ArrowElectronicsESC/BluetoothXpressShield/Design Documents/PBOM.xlsx

Item# | Designator | Quantity | Production Description_SL | Production MFG_SL | Production P/N_SL
0 | PCB | 1 | 2.1X2.7,2 | Bittele | 49975B#0_20181128
1 | Y1 | 1 | Crystals 32.768KHz 7pF | Abracon Corporation | ABS07-32.768KHZ-7-T
2 | U3 | 1 | Consigned part: Imported | Consigned part: Analog Devices Inc. | Consigned part: ADG3308BRUZ or ADG3308BRUZ-REEL7
3 | U4 | 1 | IC REG LINEAR 3.3V 300MA TSOT5 | Analog Devices Inc | ADP122AUJZ-3.3-R7
4 | U7, U8, U9, U10 | 4 | Trans GP BJT NPN 45V 1A 2000mW Automotive 4-Pin(3+Tab) SOT-223 T/R | Diodes Incorporated | BCP5410TA
5 | U2 | 1 | Consigned part: BGX13S | Consigned part: Silicon Labs | Consigned part: BGX13S or BGX13S22GA-V21
6 | C1, C2, C3, C5, C6, C21 | 6 | Consigned part: Cap Ceramic 10V Pad SMD 0402 125°C T/R | Consigned part: Taiyo Yuden | Consigned part: C0402C104K8RAC or LMK105B7104MVHF
7 | C7, C8 | 2 | Consigned part: Cap Ceramic 10V Pad SMD 0402 125°C T/R | Consigned part: Taiyo Yuden | Consigned part: C0402C104K8RAC or LMK105B7104MVHF
8 | C11, C12, C13, C14, C17, C18, C19, C20 | 8 | Consigned part: Cap Ceramic 10V Pad SMD 0402 125°C T/R | Consigned part: Taiyo Yuden | Consigned part: C0402C104K8RAC or LMK105B7104MVHF
9 | C9, C10, C15, C16 | 4 | CAP CER 0.1UF 10V Y5V 0402 | KEMET Corporation | C0402C104Z8VAC7867
10 | R11 | 1 | Thick Film Resistors - SMD 1/16watt 91ohms 5% | Vishay Intertechnologies | CRCW040291R0JNED
11 | R25, R29, R39, R43 | 4 | RES SMD 1K OHM 1% 1/16W 0402 | Vishay Dale | CRCW04021K00JNEDC
12 | R7, R8, R9, R10 | 4 | Thick Film Resistors - SMD 1/16watt 1.5Kohms 1% Commercial Use | Vishay Intertechnologies | CRCW04021K50FKEDC
13 | R16, R18, R30, R32 | 4 | Thick Film Resistors - SMD 1/16watt 3.3Kohms 5% Commercial Use | Vishay Intertechnologies | CRCW04023K30JNEDC
14 | R2, R3,R44,R45 | 4 | Thick Film Resistors - SMD 1/16watt 7.5Kohms 5% | Vishay Intertechnologies | CRCW04027K50JNED
15 | R1, R4 | 2 | RES SMD 33 OHM 5% 1/16W 0402 | Vishay Dale | CRCW040233R0JNEDC
16 | R20, R21, R22, R23, R24, R26, R27, R28, R34, R35, R36, R37, R38, R40, R41, R42 | 16 | RES SMD 100K OHM 1% 1/16W 0402 | Vishay Dale | CRCW0402100KFKED
17 | R17, R19, R31, R33 | 4 | RES SMD 200K OHM 1% 1/16W 0402 | Vishay Dale | CRCW0402200KFKED
18 | R5, R6 | 2 | Thick Film Resistors - SMD 1/16watt 499Kohms 1% Commercial Use | Vishay Intertechnologies | CRCW0402499KFKEDC
19 | U5 | 1 | Operational Amplifiers - Op Amps Quad 1.8V 1MHz | Microchip Technology Inc | MCP6004T-I/ST
20 | H2 | 1 | TERM BLOCK 5.08MM HORZ 5POS PCB | On-Shore Technology Inc | OSTTC052162
21 | U6 | 1 | LED Lighting Drivers 4BIT I2C FM+ TP LED CON RST OE | NXP Semiconductors | PCA9633DP2,118
22 | S1, S2, S3, S4 | 4 | Tactile Switches TACT | C&K Components | PTS645SH50SMTR92LFS
23 | R12 | 1 | Thick Film Resistors - SMD 1/16W 49.9 Ohm 1% | YAGEO Corporation | RC0402FR-0749R9P
24 | R15 | 1 | RES SMD 56.2 OHM 1% 1/16W 0402 | YAGEO Corporation | RC0402FR-0756R2L
25 | R14 | 1 | Thick Film Resistors - SMD 63.4 OHM 1% | YAGEO Corporation | RC0402FR-0763R4L
26 | R13 | 1 | RES SMD 205 OHM 1% 1/16W 0402 | YAGEO Corporation | RC0402FR-07205RL
27 | U1 | 1 | Consigned part: Temp Sensor Digital Serial (I2C) 6-Pin DFN EP T/R | Consigned part: Silicon Labs | Consigned part: SI7050-A20-IMR
28 | AD1 | 1 | Consigned part: CONN RCPT .100" 6POS SNGL GOLD | Consigned part: Samtec Inc | Consigned part: SSQ-106-02-G-S or SSQ-106-03-F-S
29 | IOL1 | 1 | Consigned part: SSQ-108-03-G-S | Consigned part: Samtec Inc | Consigned part: SSQ-108-03-G-S
30 | POWER1 | 1 | Consigned part: SSQ-108-03-G-S | Consigned part: Samtec Inc | Consigned part: SSQ-108-03-G-S
31 | IOH1 | 1 | Consigned part: SSQ-110-03-F-S | Consigned part: Samtec Inc. | Consigned part: SSQ-110-03-F-S
32 | D4, D8 | 2 | Consigned part: Imported | Consigned part: Visual Communications Company - VCC | Consigned part: VAOL-S8GT4
33 | D5 | 1 | Standard LEDs - SMD Red 624nm | Visual Communications Company | VAOL-S8RP4
34 | D6 | 1 | Standard LEDs - SMD Blue 468nm | Visual Communications Company | VAOL-S8SB4
35 | D7 | 1 | LED WHITE DIFFUSED 0805 SMD | Visual Communications Company | VAOL-S8WR4
36 | U11 | 1 | Consigned part: Light to Digital Ambient Light Sensor Digital Output 3.3V 6-Pin T/R | Consigned part: Vishay Semiconductor Opto Division | Consigned part: VEML6030
37 | D1, D2 | 2 | Standard LEDs - SMD 0402 BLUE Non-Diff | Vishay Intertechnologies | VLMB1500-GS08
38 | D3 | 1 | Standard LEDs - SMD 0402 SUPER RED Non-Diff | Vishay Intertechnologies | VLMS1500-GS08
39 | U12 | 1 | MOSFET 2N-CH 20V 0.3A 6-DFN | Diodes Incorporated | DMN2005DLP4K-7
40 | J6 | 1 | Consigned part: | Consigned part: Samtec | Consigned part: SSQ-114-03-T-S
