ArrowElectronicsESC/BluetoothXpressShield/(threads)

Thread 2 (2019-03-04):

Missing schematics

stomascik, 2019-03-04:
Hello,

can you please release .pdf schematics of this board? In the Design Documents/BGX13_Shield_V1_0.zip are assembly files only.

Thank you.
Slavomir Tomascik

ebeppler03, 2019-04-23:
Slavomir - I have attached them here and they will be added to the next Github update.
[BGX_Shield_V1_0.pdf](https://github.com/ArrowElectronicsESC/BluetoothXpressShield/files/3108199/BGX_Shield_V1_0.pdf)

microwattbott, 2019-04-23:
Dear Sir,
     Thanks.  I needed that.  I cannot seem to get any
signal/voltage/current from the LED screw block.  The BLE works great
mostly.  I had a led and resistor in series connected to red and ground and
the default is totem mode on that output.   No Joy.  it did not light up
and my VOM could not detect any signal.  The onboard LEDs flash perfectly.
Are there a known problems with the  PCA9633 output drive on the
SLASH1000A?  I set the .ino Global variable OUTPUT_MODE to 1 and it made no
difference to detecting signal at the LED block.   I added the following
code to try and get the PCA9633 to send the signal to the external LED
driver.  Still no joy.
  if (!OUTPUT_MODE)  {    // could not get a single led to light
                          //on PWM output for lighting controller
    dimmer->onBoardMode();  // !! deduced solution :  independent
               // power supply required for "lighting controller"
              //  due to "open drain" congifuration  * change
                 // made from totem-pole config
  } else   {      // looked at this to see if program can get
                              // control of the invert verses
    dimmer->outputMode();   // non-invert parameter for PCA9633
                         // enable lighting controller output.
 }
Can you please point me in the right direction?

Thanks.

On Tue, Apr 23, 2019 at 10:08 AM ebeppler03 <notifications@github.com>
wrote:

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

ebeppler03, 2019-04-23:
Hi Microwattbott,

FYI the Screw block terminal is a 0-10V dimming controller designed for use with a system like this: https://www.arrow.com/en/products/ess030w-0500-56/energy-recovery-products-erp

The output is not driven, but is rather a current sinking output. This is a very common control system used in lighting systems. More info can be found here: https://en.wikipedia.org/wiki/0-10_V_lighting_control

Thanks!

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

microwattbott, 2019-04-23:
thank you, the wiki link for 0-10 V lighting control
<https://en.wikipedia.org/wiki/0-10_V_lighting_control> will be very useful.
I am wanting to test the output block without spending $40.00 for the extra
hardware.  I am going to check if my flourescent fixtures to see if I have
one that is dimmable with the 0-10 V control.   Thanks again for the wiki
link and the circuit *schematic *diagram.

On Tue, Apr 23, 2019 at 10:56 AM ebeppler03 <notifications@github.com>
wrote:

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

microwattbott, 2019-04-28:
A little web research led me to an easy to understand home brew lighting control circuit that should be usable with the SLASH1000A terminal block OR just an Arduino.  Here is the link : [https://maker.pro/arduino/projects/arduino-lamp-dimmer](https://maker.pro/arduino/projects/arduino-lamp-dimmer).
Of course, four of that circuit would be needed to use the full RGBW capabilities or the SLASH1000A.

Closed 2019-04-23.

Thread 3 (2019-04-23):

CHALLENGE OF FINDING THE INFO WHEN USING THE SLASH1000A

microwattbott, 2019-04-23:
Yes, I know it is the .pdf includes a link to the github.  BUT the .pdf has been un-linked from the arrow.com page for the board.
This is what I need:     Some where on this github page AND in the (all) zipped files MUST be included the device's name:  SLASH1000A.   Is there any bonafide reason for creating this firewall of secrecy?  The github search engine should direct me to these pages when I query it for SLASH1000A.  My PC should find the zip file on my harddrive when I look for SLASH100A.

ebeppler03, 2019-04-23:
Hi microwattbott - Sorry for the confusion - The github link has been re-added to the SLASH1000A page on Arrow.com. Unfortunately the 'SLASH1000A' Name was decided on fairly late in the process so the name isn't on all the materials - A readMe will be added to the next update to help mitigate this and provide installation instructions for the library.

Closed 2019-04-23.
