ArrowElectronicsESC/BluetoothXpressShield/Design Documents/BGX_Shield_V1_0.pdf

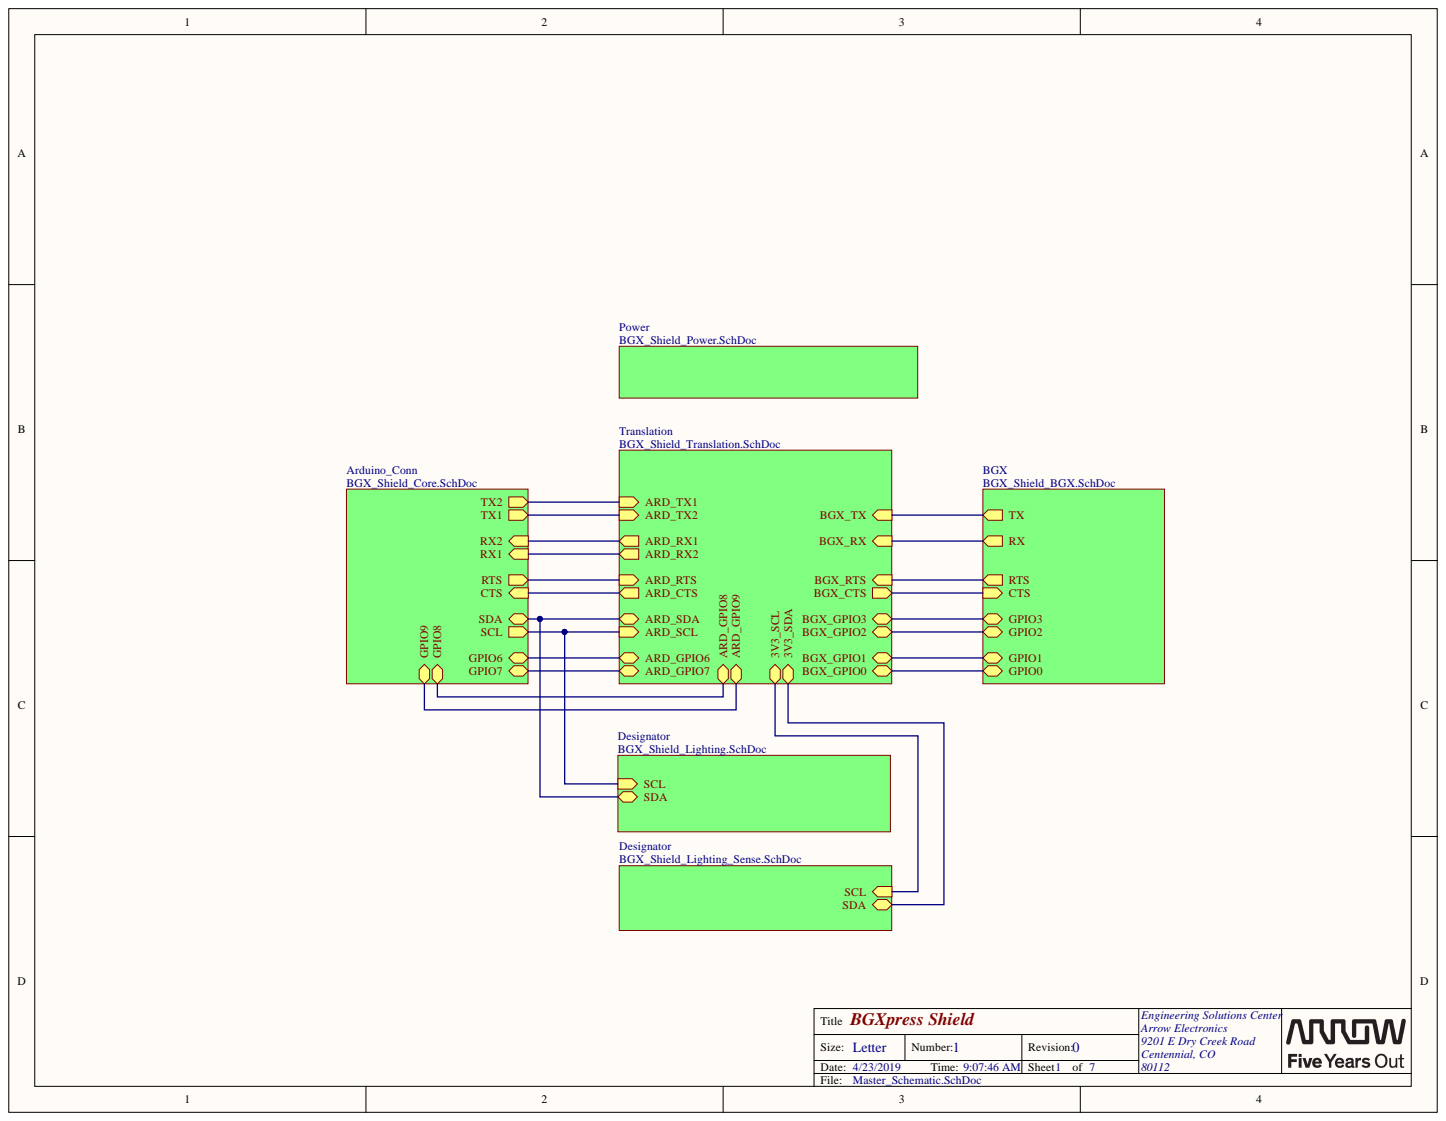
[picture p4: page 1]

Designator BGX_Shield_Lighting.SchDoc

SCL SDA

BGXpress Shield Title | Engineering Solutions Center Arrow Electronics 9201 E Dry Creek Road Centennial, CO

Size: Letter | Number: | Revision:
Date: 4/23/2019 Time: 9:07:46 AM | | Sheet of

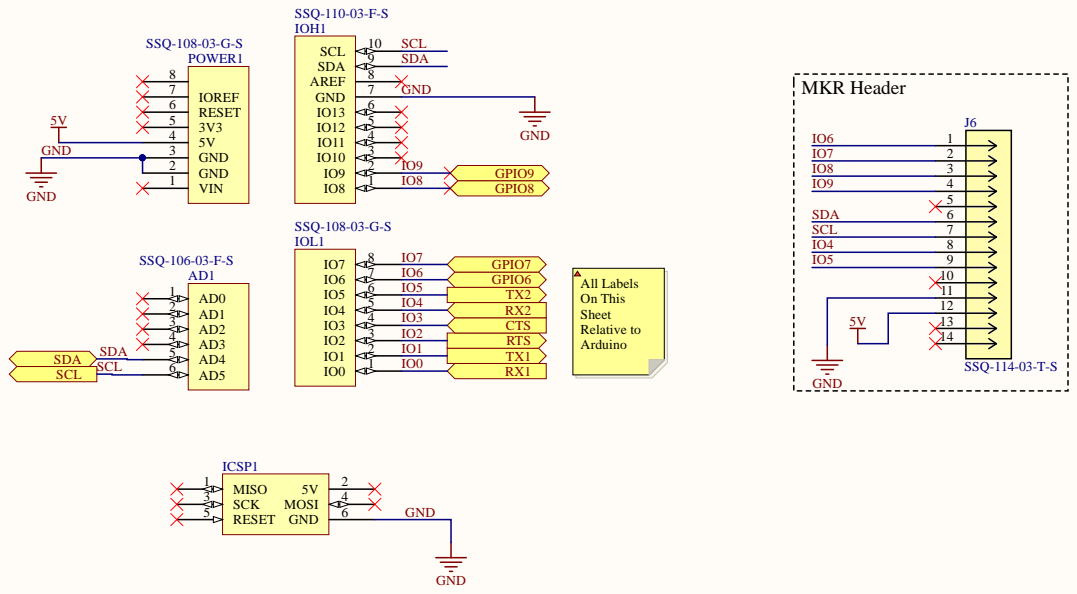
[picture p5: page 2]

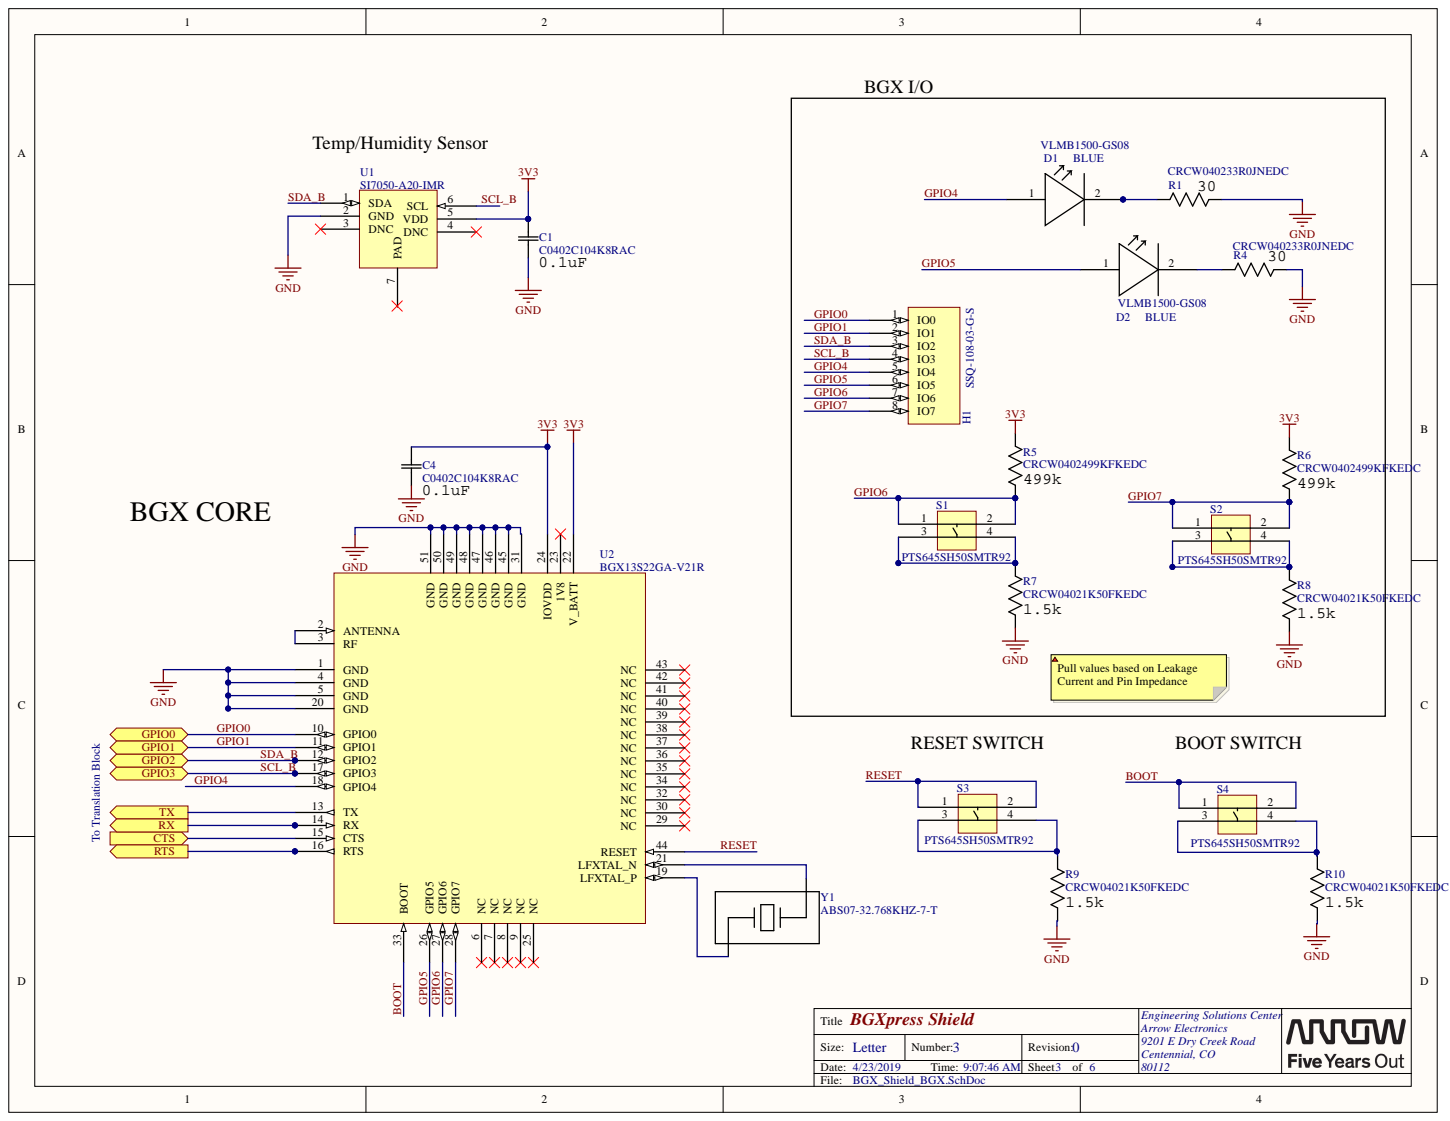
[picture p6: page 3]

GND 45 GND 46 GND 47 GND 48 GND 49 GND 50 GND 51

Pull values based on Leakage
Current and Pin Impedance

GND 4
GND 5
GND 20

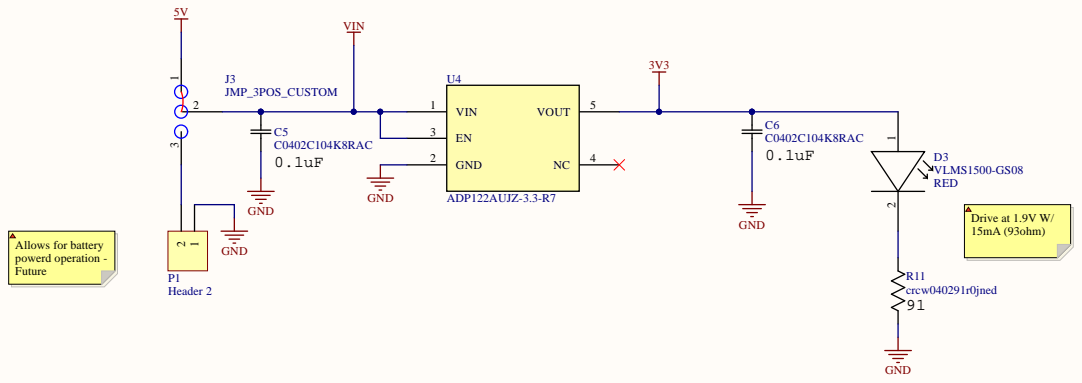
[picture p7: page 4]

Engineering Solutions Center Arrow Electronics 9201 E Dry C reek Road Centennial, C O

Number:

4/23/2019 Time: 9:07:46 A M | | Sheet of

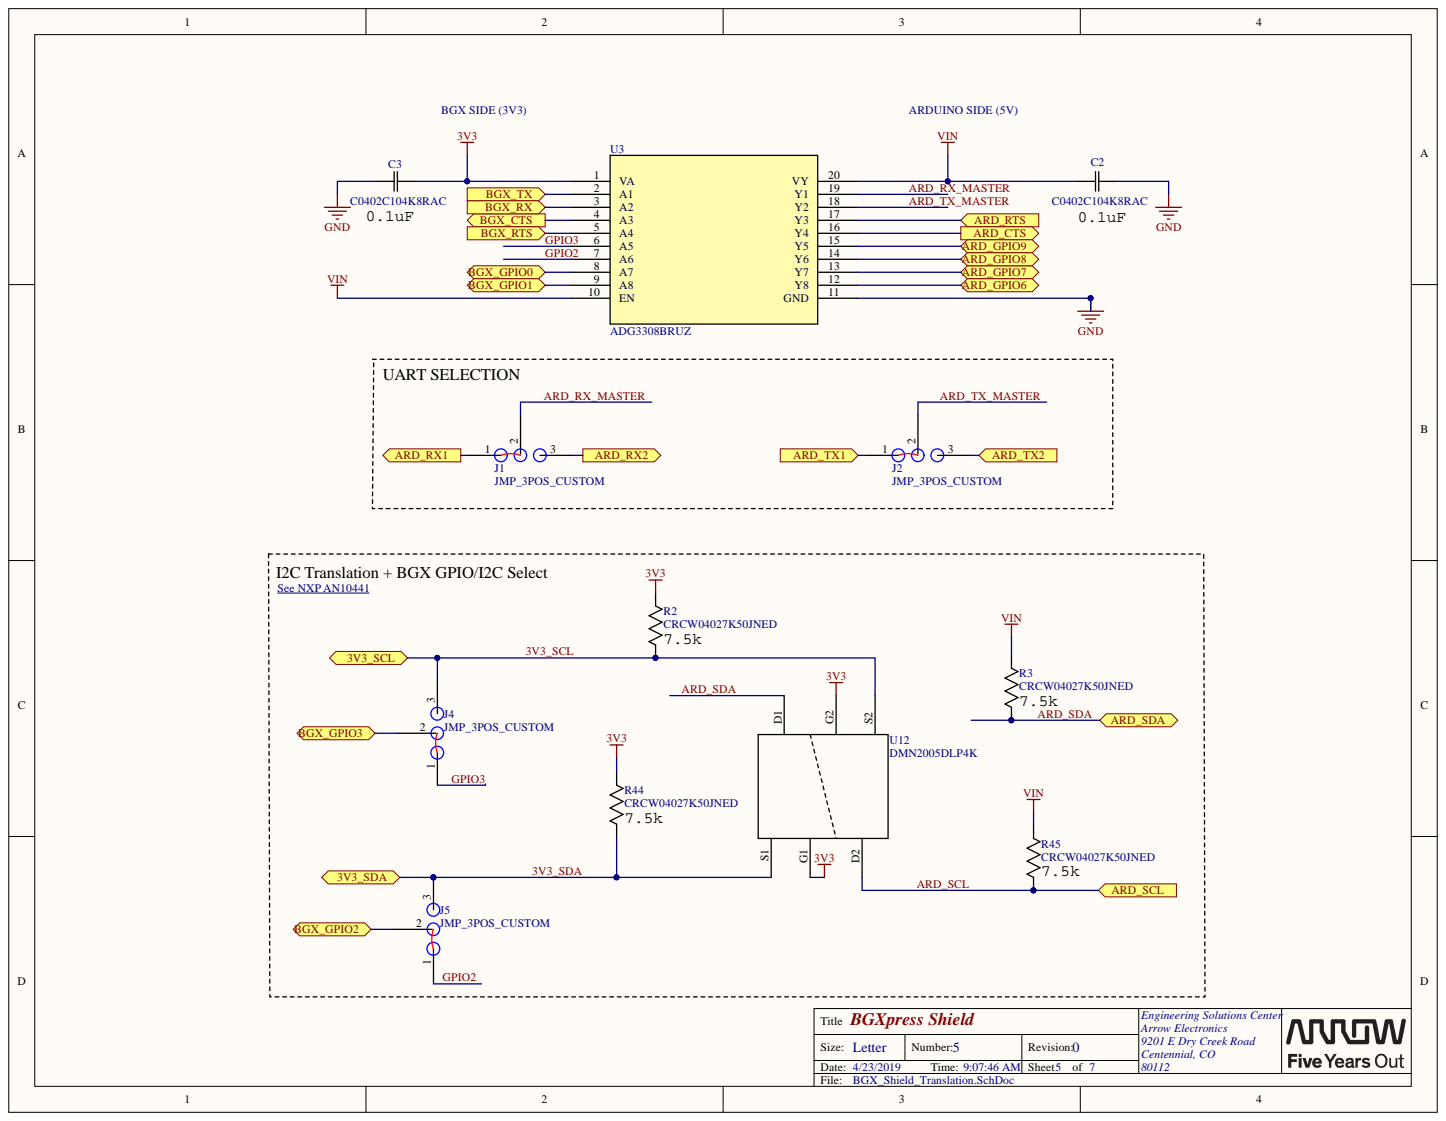
[picture p8: page 5]

I2C Translation + BGX GPIO/I2C Select See NXP AN10441 (https://cdn-shop.adafruit.com/datasheets/AN10441.pdf)

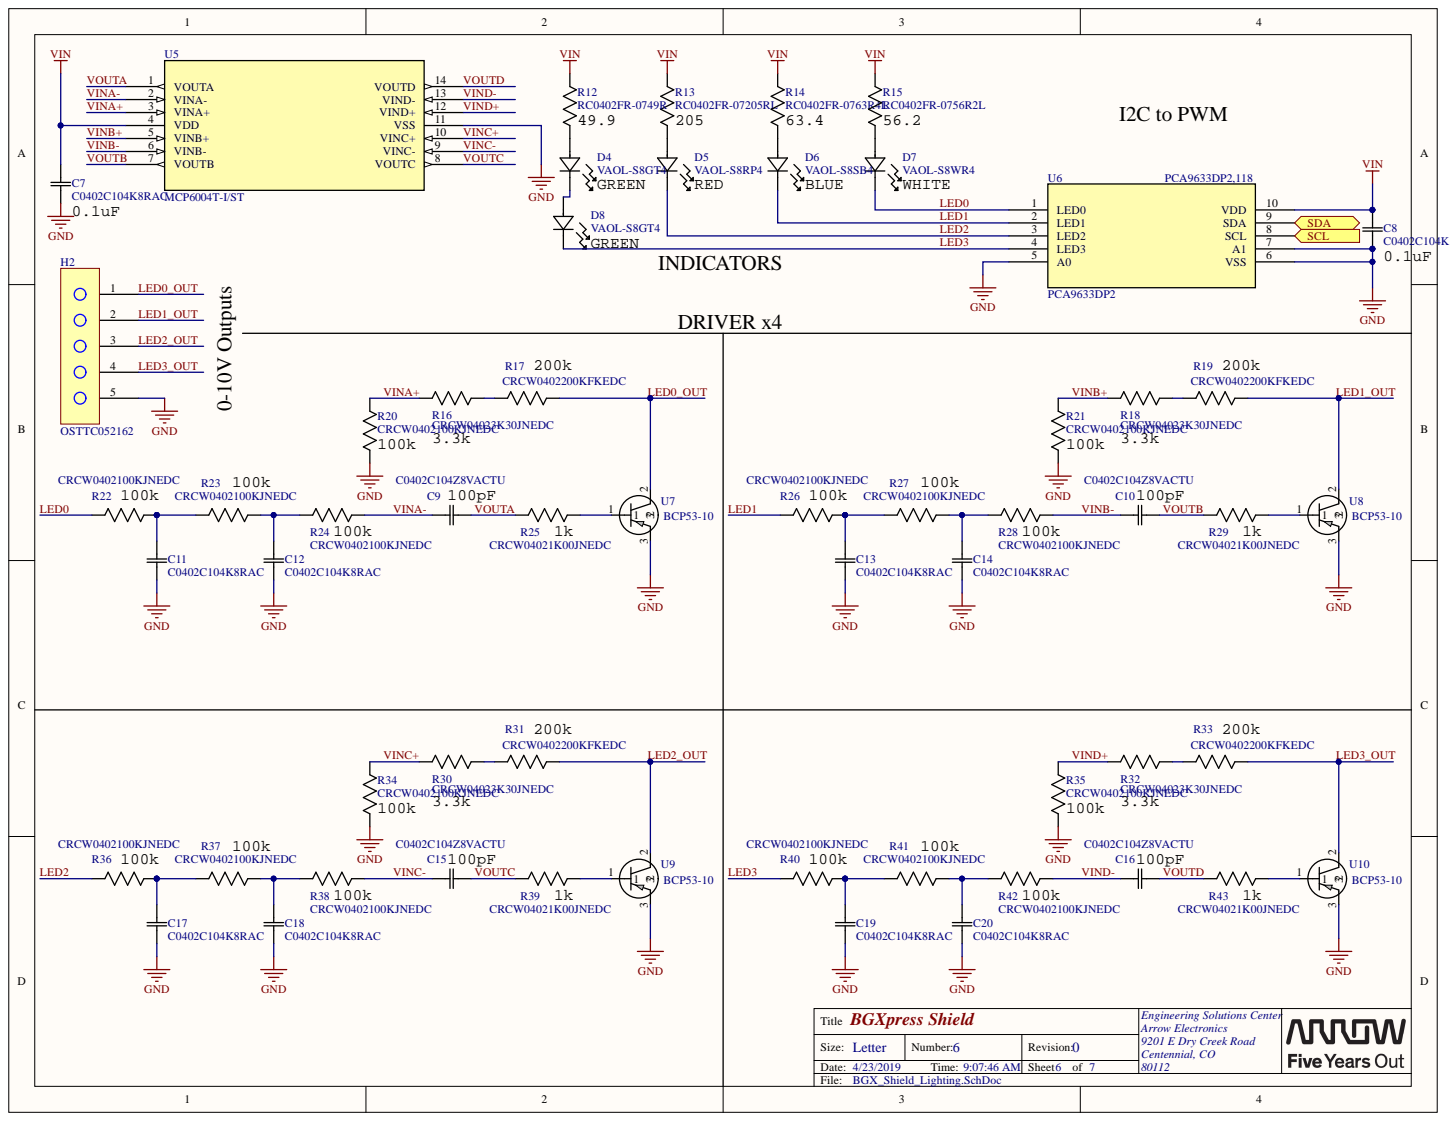
[picture p9: page 6]

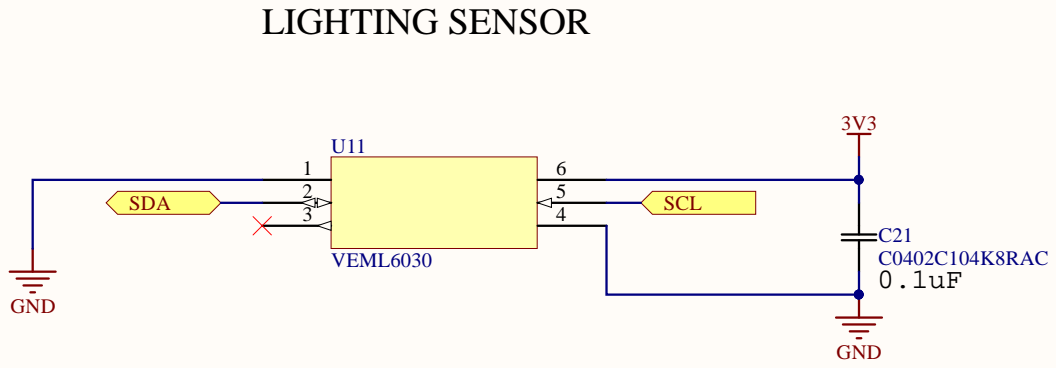
[picture p10: page 7]

Engineering Solutions Center Arrow Electronics 9201 E Dry C reek Road Centennial, C O

Number:

4/23/2019 Time: 9:07:46 A M | | Sheet of
