ArrowElectronicsESC/BluetoothXpressShield/Library Files/BluetoothExpress/BluetoothExpressDefines.h

/************************************************************************
File: BluetoothExpressDefines.h
Version: V1.0
Release Date: February 4, 2019
Authors: Eric Beppler, Andrew Reisdorph, Arrow Electronics

Description: The defines in this file are provided for the 
Bluetooth Express library to ease development

Contact ESC@Arrow.com for all inquiries with the subject SLASH1000


This file is distributed by ARrow Electronics under the MIT License. 
See License.txt for more details.
***************************************************************************/
#ifndef BGXDefines_h
#define BGXDefines_h

// Unused variable filter to prevent warnings
#define UNUSED(p) ((p)=(p))

#define BUS_MODE_PIN 6 //Default Pin for BGX13 Arduino Shield 
//This will change the pin configuration for arduino only
#define SET_COMMAND_MODE() ;//digitalWrite(BUS_MODE_PIN, LOW)
#define SET_STREAM_MODE() ;//digitalWrite(BUS_MODE_PIN, HIGH)

#define RX_PIN 4
#define TX_PIN 5

#define UART_BUFFER_SIZE 200
#define RESET_UART_RX _uart_rx_write_ptr = 0

#define READ_DELAY 20
#define ADDRESS_END_INDEX 22
#define ADDRESS_INDEX 10
#define VERSION_BEGIN 5
#define SPACE ' '

#define CMD_CLEAR_BONDING_INFO 		"clrb"
#define ADVERTISE_HIGH 				"adv high"
#define ADVERTISE_LOW 				"adv low"
#define ADVERTISE_OFF				"adv off"
#define DISCONNECT					"dct"
#define FACTORY_RESET				"fac "
#define GET_BT_ADDR					"get bl a"
#define REBOOT						"reboot"
#define SCAN 						"scan"
#define SAVE						"save"
#define SLEEP						"sleep"
#define STREAM_MODE		      		"str"
#define UPDATE_UART_SETTINGS		"uartu"
#define GET_LAST_USER_FUNC_STATUS	"ulast"
#define WAKE						"wake"

static const char stream[] PROGMEM = "STREAM_MODE";
static const char command[] PROGMEM = "COMMAND_MODE";
static const char success[] PROGMEM = "Success";

enum BGX_states{
	RESTART,
	INIT_BGX,
	INIT_SENSORS,	
	INIT_LIGHTING,
	WAIT_FOR_CONN,
	RUNNING
};

enum BGX_input_direction {
	INPUT_DIRECTION_IN = 0,
	INPUT_DIRECTION_IN_PULLDOWN,
	INPUT_DIRECTION_IN_PULLUP,
	INPUT_DIRECTION_INTERRUPT,
	INPUT_DIRECTION_INTERRUPT_PULLUP,
	INPUT_DIRECTION_INTERRUPT_PULLDOWN
};

// Moved to only used scope in BGX13::gpioSetIn
// static const char * inDirections[] = { 
//     "in",   //0
//     "ipd",  //1
//     "ipu",  //2
//     "inw",  //3
//     "ipuw", //4
//     "ipdw"  //5
// };

enum BGX_output_direction {
	OUTPUT_DIRECTION_LOW = 0,
	OUTPUT_DIRECTION_HIGH,
	OUTPUT_DIRECTION_HIGH_Z
};

// Moved to only used scope in BGX13::gpioSetOut
// static const char * outDirections[] = {
//     "olo", //0
//     "ohi", //1
//     "hiz"  //2
// };

// Moved to only used scope in BGX13::gpioSetOut
// static const char * pushPullModes[] = {
//     "pp", //0
//     "od", //1
//     "os"  //2
// };

// Moved to only used scope in BGX13::gpioSetOut
// static const char * driveStrengths[] = {
//     "drvst", //0
//     "drvwk"  //1
// };

#endif
