ArrowElectronicsESC/BluetoothXpressShield/Library Files/BluetoothExpress/BluetoothExpress.h

/************************************************************************
File: BluetoothExpress.h
Version: V1.0
Release Date: February 4, 2019
Authors: Eric Beppler, Andrew Reisdorph, Arrow Electronics

Description: This file contains the declarations for the BGX13 class.
This class is designed to interface with the BGX13S From Silicon Labs 
The functions are based on the command set provided with the BGX13

Details on the function of the commands can be found in the BGX13 documentation



Contact ESC@Arrow.com for all inquiries with the subject SLASH1000


This file is distributed by Arrow Electronics under the MIT License. 
See License.txt for more details.
************************************************************************/


#ifndef BGX_h
#define BGX_h


#include "Arduino.h"

#include "BluetoothExpressDefines.h"

#if defined(ARDUINO_AVR_UNO)
  #include <SoftwareSerial.h>
#else
  #define TWCR 0
#endif

class BGX13
{
  public:
#if defined(ARDUINO_AVR_UNO)
  	BGX13(SoftwareSerial * arduinoSoftwareSerial); //Initialize the BGX connection
#endif
    BGX13(HardwareSerial  *arduinoHardwareSerial);
    void serialConnect(long baud);
    int BGXRead(void);
    int printBGXBuffer(void);
    int getBGXBuffer(char* data);
    void sendCommand(int readTime);
    void sendString(char* toSend);
    //adv - functions for advertising as a peripherial
  	void advertiseHigh(void);
  	void advertiseLow(void);
  	void advertiseOff(void);
  	//clrb - Deletes all bonding information
  	void clearBondingInfo(void); 
  	//dct - Disconnect from Peripherial or Central
  	void disconnect(void);
  	//fac - Factory Rest
  	void factoryReset(void);
  	//gdi - Set GPIO direction and pin mode
  	void gpioSetIn(int number, BGX_input_direction direction, int debounce=-1);
  	void gpioSetOut(int number, BGX_output_direction direction, int mode=-1, bool enablePullResistor=true, int driveStrength=0);
  	//get - Get the value of a variable
  	void getVariable(char *variable, char *buffer, int length);
  	//gfu - Select GPIO Function
  	void selectGPIOFunction(int gpioNumber, const char *function);
  	//gge - Get GPIO value
  	int getGPIOValue(int number);
  	//gse - Set Gpio Value
  	void setGPIOValue(int number, int value);
  	//reboot - Restart the device
  	void reboot(void);
  	//save
    void saveConfiguration(void);
  	//scan
  	void scan(int timeScan);
  	//set
    void setVariable(const char *variable, const char *value);
  	//sleep
    void sleepMode(void);
  	//str
    void streamMode(void);
  	//uartu
    void updateUartSettings(void);
  	//uevt
    void userEventTrigger(int functionNumber, bool assertHigh, int gpioNumber);
  	//ufu
    void userFunctionAssign(int number, char* function);
  	//ulast
    void getLastUserFunctionResult(void);
  	//urun
    void userFunctionRun(int number);
  	//ver - Returns the version number of the BGX13
  	void getVersion(char* ver);
  	//wake
    void wake(void);
    //Destructor
    ~BGX13(void);

  private:
  	uint8_t _state;
    Stream *_bgxSerial;
    char _uart_tx_buffer[UART_BUFFER_SIZE];
    char _uart_rx_buffer[UART_BUFFER_SIZE];
    int _uart_rx_write_ptr = 0;
  	void waitForStreamMode(void);
    void setCommandMode(void);
    void serialBegin(long baud);
    bool _swSerial = false;
};

#endif //ifndef BGX_h 
