ArrowElectronicsESC/BluetoothXpressShield/(commit log)

2019-02-05 First Commit - V1 of all files
    [PBOM.xlsx]
2019-04-23 Demo improvements and schematics added
2019-04-23 code cleanup/formatting, replace deprecated NULL, use PROGMEM, fix some scopes (#4)
    Adding code cleanups from @EmbeddedDesign
    [ArrowBGXShield.cpp, ArrowBGXShield.h, BluetoothExpress.cpp, BluetoothExpress.h, BluetoothExpressDefines.h, Demo.ino]
